xdylanm/multiply-accumulate/README.md

# Multiply Accumulate

A 4HP module with a four-quadrant multiplier.
