xdylanm/multiply-accumulate/docs/assets/images/AN532-D_fig3.png

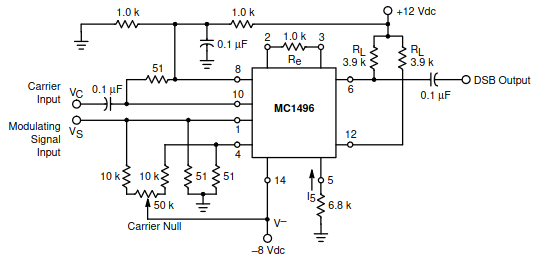
docs/assets/images/AN532-D_fig3.png
