xdylanm/multiply-accumulate/docs/assets/images/yusynth_upper_bias.png

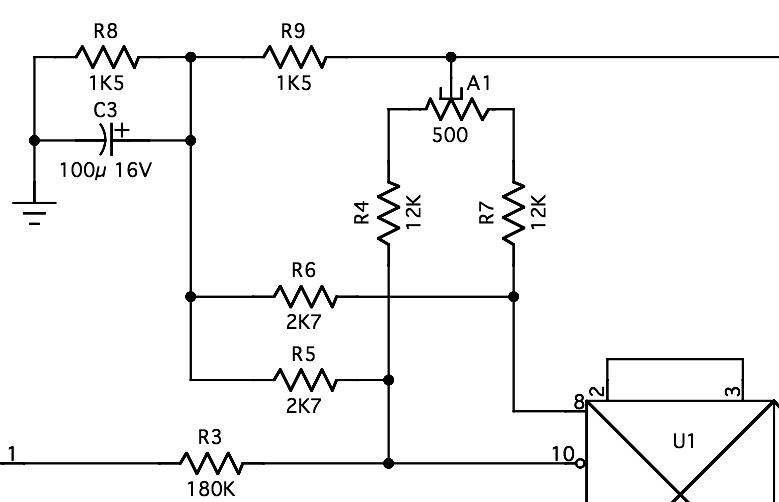
docs/assets/images/yusynth_upper_bias.png
