xdylanm/multiply-accumulate/docs/assets/images/yusynth_upper_bias_redrawn.png

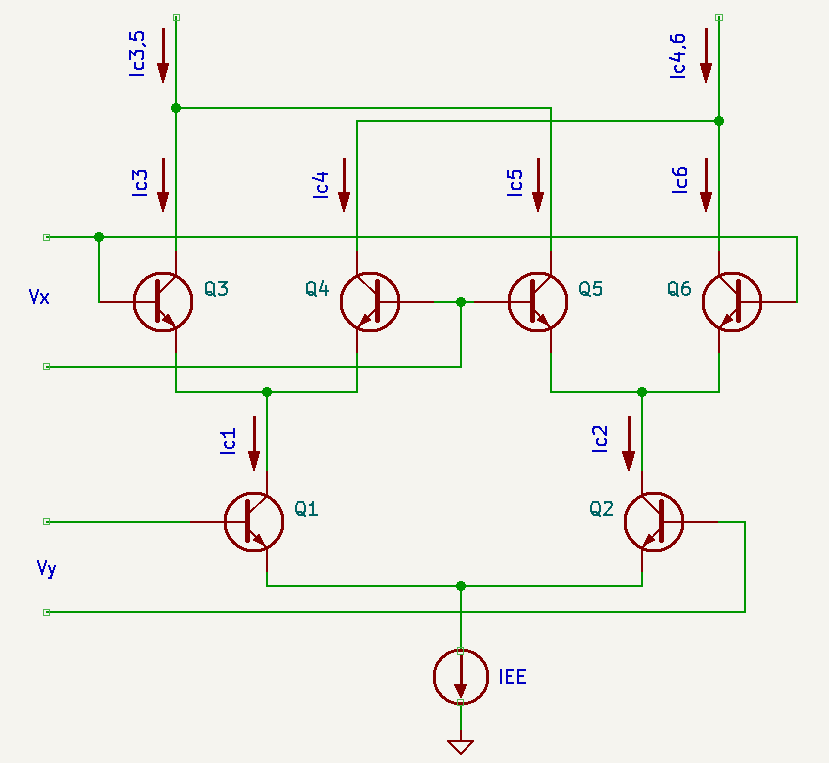
docs/assets/images/yusynth_upper_bias_redrawn.png
