xdylanm/multiply-accumulate/docs/assets/images/yusynth_upper_bias_simple_Zin.png

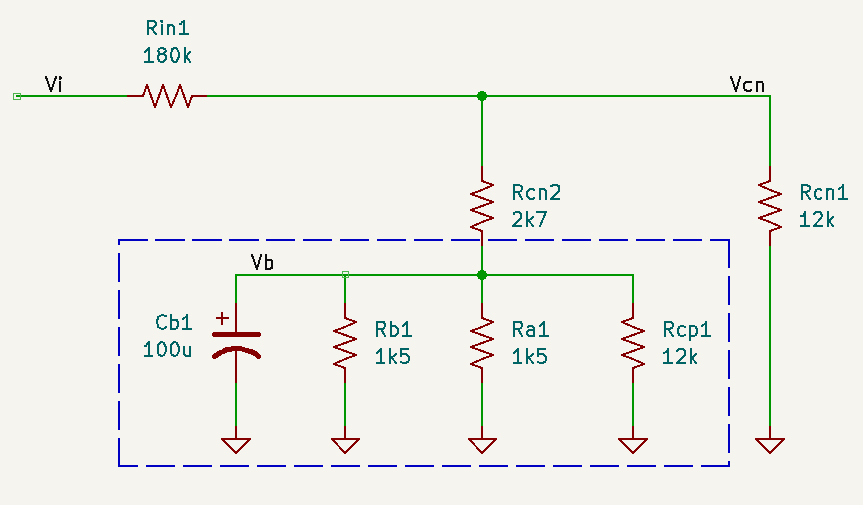
docs/assets/images/yusynth_upper_bias_simple_Zin.png
