xdylanm/multiply-accumulate/docs/assets/bom.md

| Reference | Qty | Value | Footprint |
| --- | --- | --- | --- |
| C1 | 1 | 100u | Radial D5.0mm P2.00mm |
| C2,C3,C4,C5,C6 | 5 | 100n | 0805 |
| C7,C8 | 2 | 10u | Radial D5.0mm P2.00mm |
| D1,D2 | 2 | B140-E3 | SMA |
| FB1,FB2 | 2 | 470 | 0805 |
| J1,J2,J3,J4 | 4 | Mono Jack  | WQP-PJ301M-12 |
| J5 | 1 | Conn 02x05 | IDC Header 02x05 P2.54mm Vertical |
| R1,R2,R5,R6 | 4 | 47k | 0805 |
| R3,R4,R7,R8 | 4 | 100k | 0805 |
| R9,R14 | 2 | 150k | 0805 |
| R10,R13,R15,R18,R20 | 5 | 2k2 | 0805 |
| R11,R12,R17,R19,R28 | 5 | 10k | 0805 |
| R16 | 1 | 1k0 | 0805 |
| R21 | 1 | 4k7 | 0805 |
| R22,R23 | 2 | 1k8 | 0805 |
| R24,R25,R26,R27 | 4 | 18k | 0805 |
| R29,R30 | 2 | 68k | 0805 |
| R31 | 1 | 1k | 0805 |
| RV1,RV2 | 2 | 100k | RV09 |
| RV3,RV4 | 2 | 1k0 | Bourns 3314J |
| U1 | 1 | TL074 | SOIC-14 |
| U2 | 1 | MC1496 | SOIC-14 |
