xdylanm/multiply-accumulate/docs/assets/example_bom.csv

Reference | Value | Qty | Footprint
C1,C2 | 220p | 2 | Capacitor_THT:C_Disc_D4.3mm_W1.9mm_P5.00mm
C3,C4,C5,C7,C8,C9 | 100n | 6 | Capacitor_THT:C_Disc_D4.3mm_W1.9mm_P5.00mm
C6,C10 | 10u | 2 | Capacitor_THT:CP_Radial_D5.0mm_P2.50mm
D1,D2 | 1N4148 | 2 | Diode_THT:D_DO-35_SOD27_P7.62mm_Horizontal
D3,D4 | D_Schottky | 2 | Diode_THT:D_DO-41_SOD81_P2.54mm_Vertical_KathodeUp
J1,J4 | LIN CV IN | 2 | AudioJacks:Jack_3.5mm_QingPu_WQP-PJ323M_Horizontal
J2,J5 | AUDIO IN | 2 | AudioJacks:Jack_3.5mm_QingPu_WQP-PJ323M_Horizontal
J3,J6 | OUT | 2 | AudioJacks:Jack_3.5mm_QingPu_WQP-PJ323M_Horizontal
J7 | Conn_02x05_Odd_Even | 1 | Connector_IDC:IDC-Header_2x05_P2.54mm_Horizontal
Q1,Q2 | BC557 | 2 | Package_TO_SOT_THT:TO-92_Inline_Wide
R1,R4,R10,R13 | 100k | 4 | Resistor_THT:R_Axial_DIN0204_L3.6mm_D1.6mm_P2.54mm_Vertical
R2,R11 | 12k | 2 | Resistor_THT:R_Axial_DIN0204_L3.6mm_D1.6mm_P2.54mm_Vertical
R3,R6,R12 | 100k | 3 | Resistor_THT:R_Axial_DIN0204_L3.6mm_D1.6mm_P7.62mm_Horizontal
R5,R7,R14,R16 | 220R | 4 | Resistor_THT:R_Axial_DIN0204_L3.6mm_D1.6mm_P2.54mm_Vertical
R8,R17 | 49k9 | 2 | Resistor_THT:R_Axial_DIN0204_L3.6mm_D1.6mm_P2.54mm_Vertical
R9,R18 | 1k | 2 | Resistor_THT:R_Axial_DIN0204_L3.6mm_D1.6mm_P7.62mm_Horizontal
R15 | 100k | 1 | Resistor_THT:R_Axial_DIN0207_L6.3mm_D2.5mm_P10.16mm_Horizontal
R19,R20 | 10R | 2 | Resistor_THT:R_Axial_DIN0204_L3.6mm_D1.6mm_P2.54mm_Vertical
RV1,RV2 | 100k | 2 | Potentiometer_THT:Potentiometer_Bourns_3296W_Vertical
RV3,RV4 | 100k | 2 | Potentiometer_THT:Potentiometer_Bourns_PTV09A-2_Single_Horizontal
U1 | TL074 | 1 | Package_DIP:DIP-14_W7.62mm_Socket
U2 | LM13700 | 1 | Package_SO:SOIC-16_3.9x9.9mm_P1.27mm
