xdylanm/multiply-accumulate/docs/assets/schematic.pdf

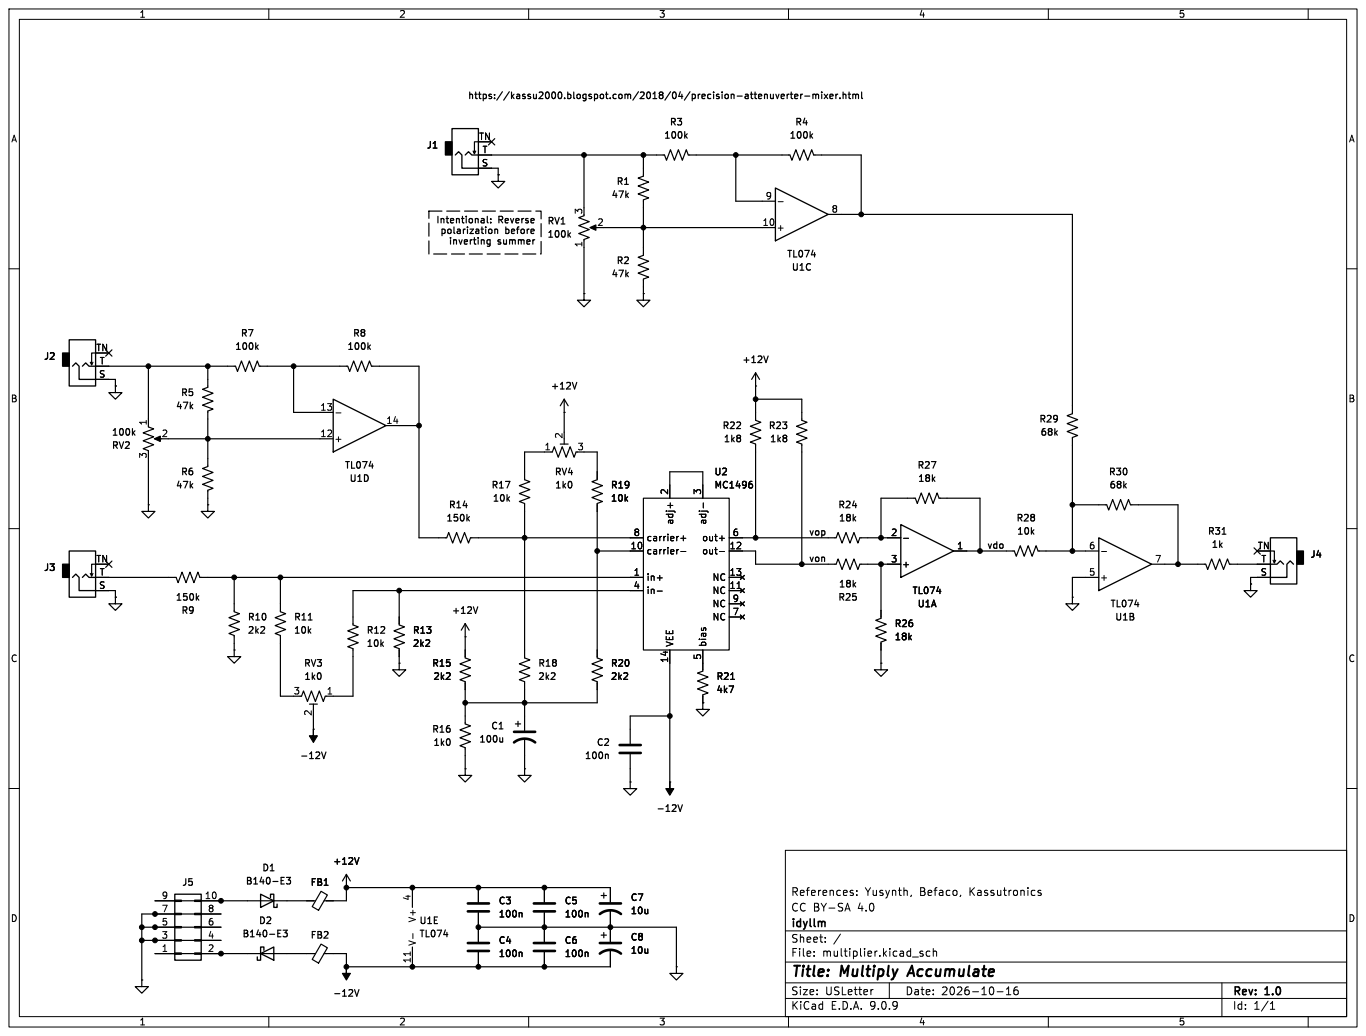
[picture p11: page 1]

2 VEE 14 adj- 3 bias 5 out+ 6

CC BY-SA 4.0 References: Yusynth, idyllm | | Befaco, | Kassutronics

E.D.A. 9.0.9 Size: USLetter | Rev: 1.0 | D Date: 2026-10-16 KiCad

File: multiplier.kicad_sch Sheet: /
Id: 1/1 Title: Multiply Accumulate
