xdylanm/multiply-accumulate/hardware/multiplier/multiplier.kicad_pcb

## KiCad design hardware/multiplier/multiplier.kicad_pcb (2026-10-17)

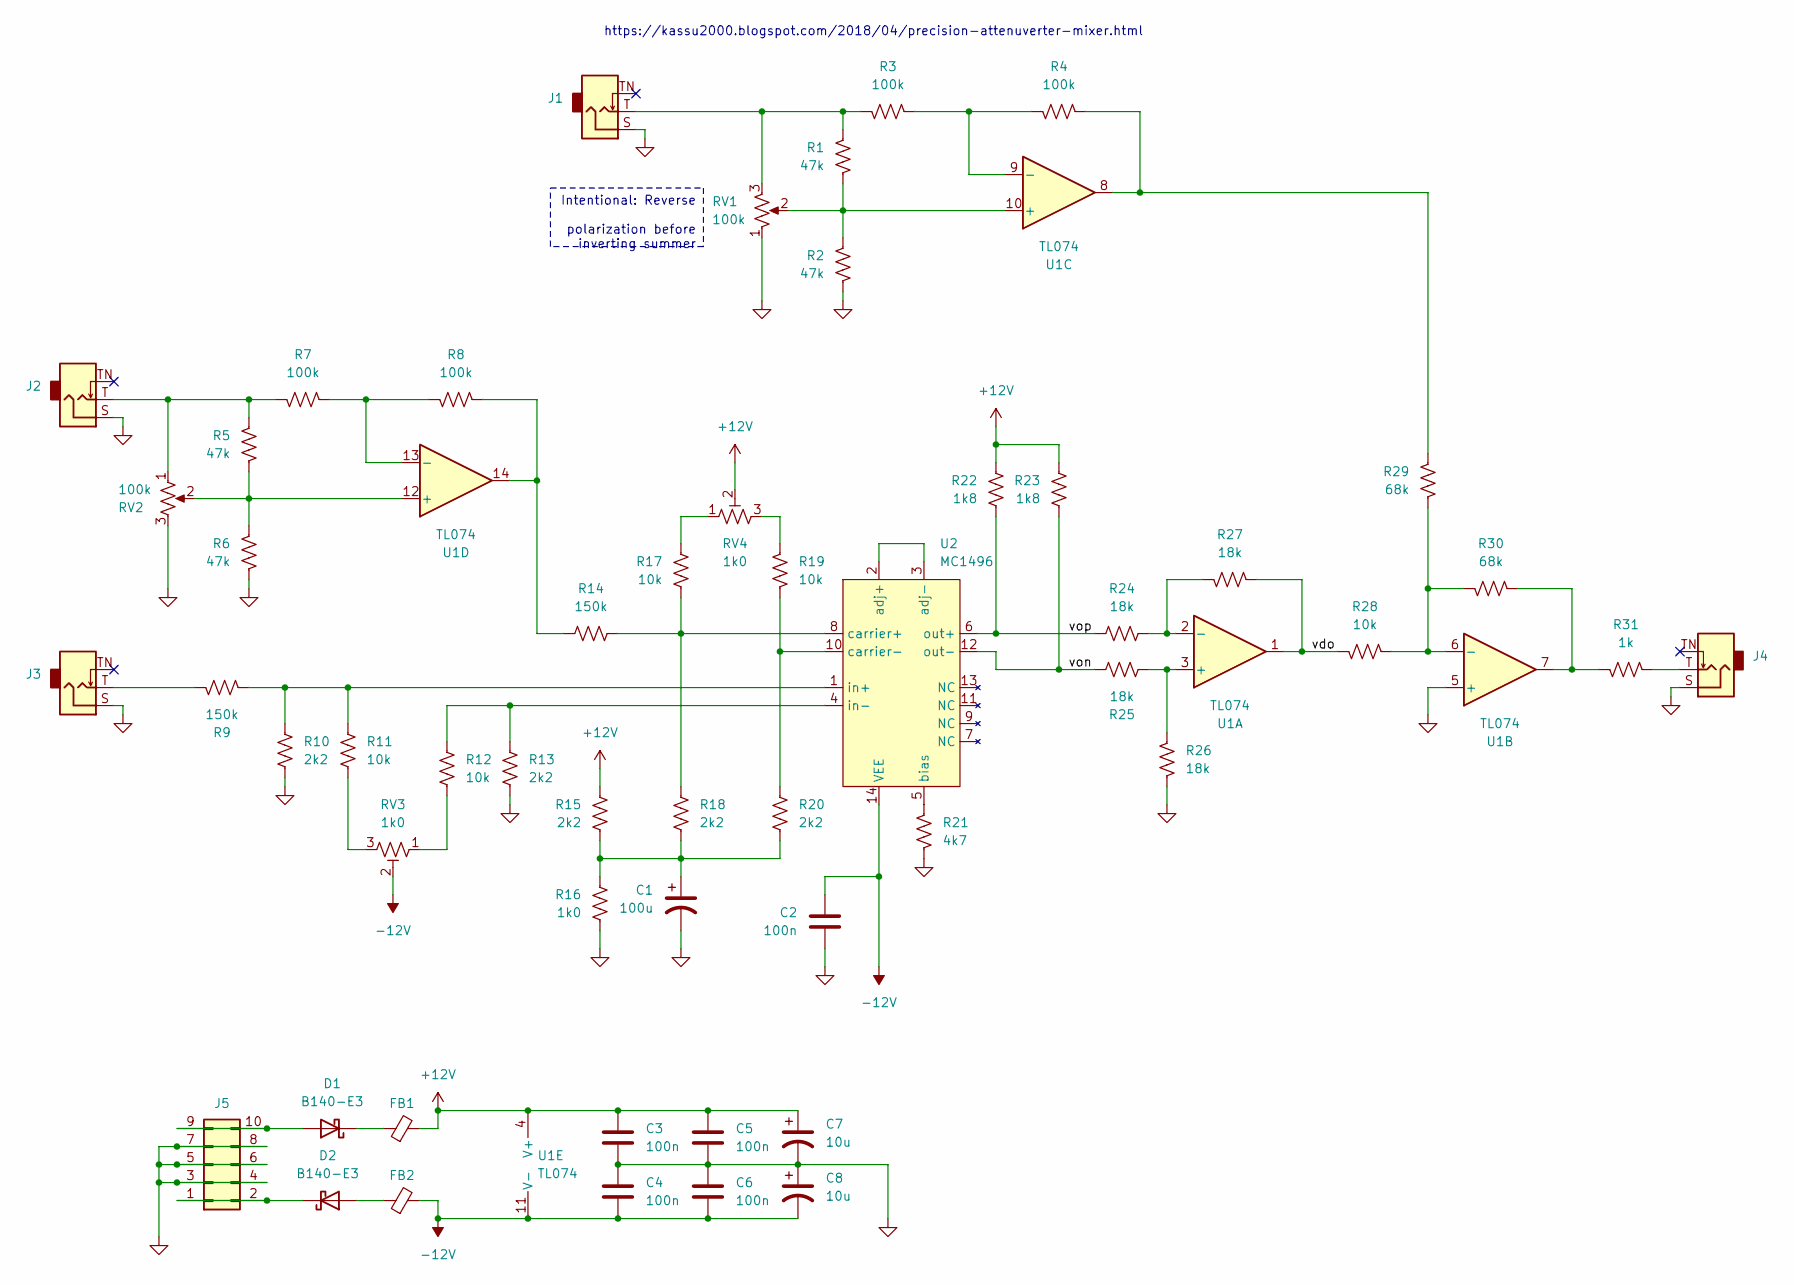
[picture p12: schematic multiplier.kicad_sch, Multiply Accumulate]

Parts:
C1: 100u; CP_Radial_D5.0mm_P2.00mm
C2, C3, C4, C5, C6: 100n; C_0805_2012Metric_Pad1.18x1.45mm_HandSolder
C7, C8: 10u; CP_Radial_D5.0mm_P2.00mm
D1, D2: B140-E3; D_SMA
FB1, FB2: FerriteBead_Small; L_0805_2012Metric_Pad1.05x1.20mm_HandSolder
J1, J2, J3, J4: AudioJack2_SwitchT; Jack_3.5mm_QingPu_WQP-PJ301M-12_Vertical_Slim
J5: Conn_02x05_Odd_Even; IDC-Header_2x05_P2.54mm_Vertical
R1, R2, R5, R6: 47k; R_0805_2012Metric_Pad1.20x1.40mm_HandSolder
R3, R4, R7, R8: 100k; R_0805_2012Metric_Pad1.20x1.40mm_HandSolder
R9, R14: 150k; R_0805_2012Metric_Pad1.20x1.40mm_HandSolder
R10, R13, R15, R18, R20: 2k2; R_0805_2012Metric_Pad1.20x1.40mm_HandSolder
R11, R12, R17, R19, R28: 10k; R_0805_2012Metric_Pad1.20x1.40mm_HandSolder
R16: 1k0; R_0805_2012Metric_Pad1.20x1.40mm_HandSolder
R21: 4k7; R_0805_2012Metric_Pad1.20x1.40mm_HandSolder
R22, R23: 1k8; R_0805_2012Metric_Pad1.20x1.40mm_HandSolder
R24, R25, R26, R27: 18k; R_0805_2012Metric_Pad1.20x1.40mm_HandSolder
R29, R30: 68k; R_0805_2012Metric_Pad1.20x1.40mm_HandSolder
R31: 1k; R_0805_2012Metric_Pad1.20x1.40mm_HandSolder
RV1, RV2: 100k; Potentiometer_Bourns_PTV09A-1_Single_Vertical_thin
RV3, RV4: 1k0; Bourns_3314J
U1: TL074; SOIC-14_3.9x8.7mm_P1.27mm
U2: MC1496; SOIC-14_3.9x8.7mm_P1.27mm

Connections:
+12V: C3.1, C5.1, C7.1, FB1.2, R15.1, R22.1, R23.1, RV4.2, U1.4 (V+)
-12V: C2.1, C4.2, C6.2, C8.2, FB2.2, RV3.2, U1.11 (V-), U2.14 (VEE)
/vdo: R27.2, R28.1, U1.1
/von: R23.2, R25.1, U2.12 (out-)
/vop: R22.2, R24.1, U2.6 (out+)
GND: C1.2, C2.2, C3.2, C4.1, C5.2, C6.1, C7.2, C8.1, J1.S, J2.S, J3.S, J4.S, J5.3, J5.4, J5.5, J5.6, J5.7, J5.8, R2.1, R6.1, R10.1, R13.1, R16.2, R21.2, R26.2, RV1.1, RV2.3, U1.5 (+)
unnamed: C1.1, R15.2, R16.1, R18.1, R20.1
unnamed: D1.2 (A), J5.9, J5.10
unnamed: D1.1 (K), FB1.1
unnamed: D2.2 (A), FB2.1
unnamed: D2.1 (K), J5.1, J5.2
unnamed: J1.T, R1.2, R3.1, RV1.3
unnamed: J2.T, R5.2, R7.1, RV2.1
unnamed: J3.T, R9.1
unnamed: J4.T, R31.2
unnamed: R11.1, RV3.3
unnamed: R12.1, RV3.1
unnamed: R8.2, R14.1, U1.14
unnamed: R17.1, RV4.1
unnamed: R19.1, RV4.3
unnamed: R4.2, R29.2, U1.8
unnamed: R30.2, R31.1, U1.7
unnamed: R25.2, R26.1, U1.3 (+)
unnamed: R24.2, R27.1, U1.2 (-)
unnamed: R28.2, R29.1, R30.1, U1.6 (-)
unnamed: R1.1, R2.2, RV1.2, U1.10 (+)
unnamed: R3.2, R4.1, U1.9 (-)
unnamed: R5.1, R6.2, RV2.2, U1.12 (+)
unnamed: R7.2, R8.1, U1.13 (-)
unnamed: U2.2 (adj+), U2.3 (adj-)
unnamed: R21.1, U2.5 (bias)
unnamed: R14.2, R17.2, R18.2, U2.8 (carrier+)
unnamed: R19.2, R20.2, U2.10 (carrier-)
unnamed: R9.2, R10.2, R11.2, U2.1 (in+)
unnamed: R12.2, R13.2, U2.4 (in-)

Notes on the sheet:
https://kassu2000.blogspot.com/2018/04/precision-attenuverter-mixer.html
Intentional: Reverse polarization before inverting summer

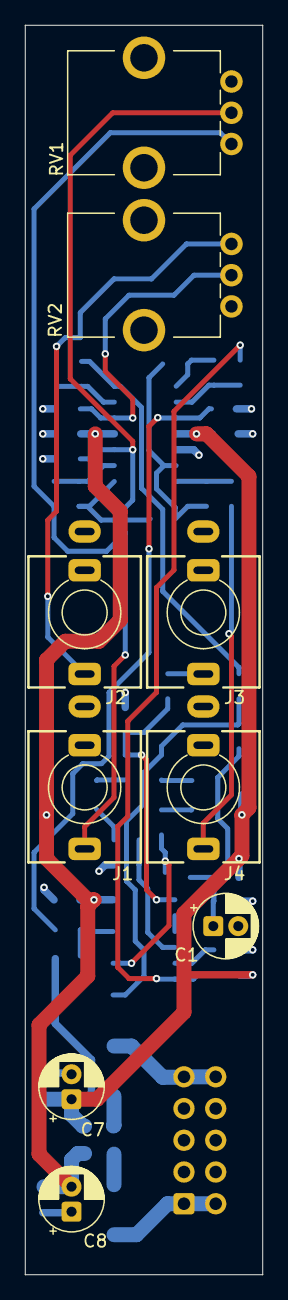
[picture p13: board multiplier.kicad_pcb from above]

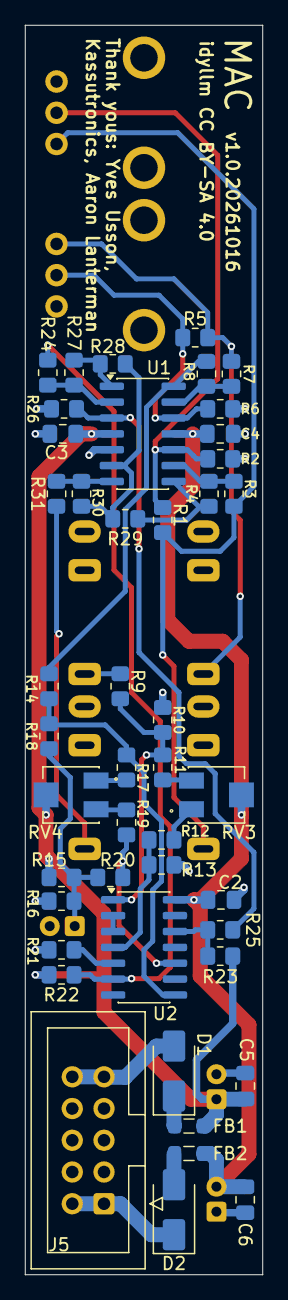
[picture p14: board multiplier.kicad_pcb from below]

Board: 4 copper layers, 19.0 x 100.0 mm, 54 parts (45 on the bottom side), 35 nets.
