xdylanm/multiply-accumulate/docs/assembly.md

# Assembly Guide

Apply solder paste with stencil, place SMT components and reflow. Place and soler THT components.

## BOM

[Download (.csv)](assets/bom.csv)

{%include-markdown "assets/bom.md"%}
