xdylanm/multiply-accumulate/(notices)

Notices in the files:
hardware/multiplier/multiplier.kicad_pcb:
idyllm CC BY-SA 4.0
